trysomethingelse/blue_pill_battery_capacity_meter/kicad/batteryCapacityMeasure_STM32F103.kicad_pcb

## KiCad design kicad/batteryCapacityMeasure_STM32F103.kicad_pcb (2019-11-14)

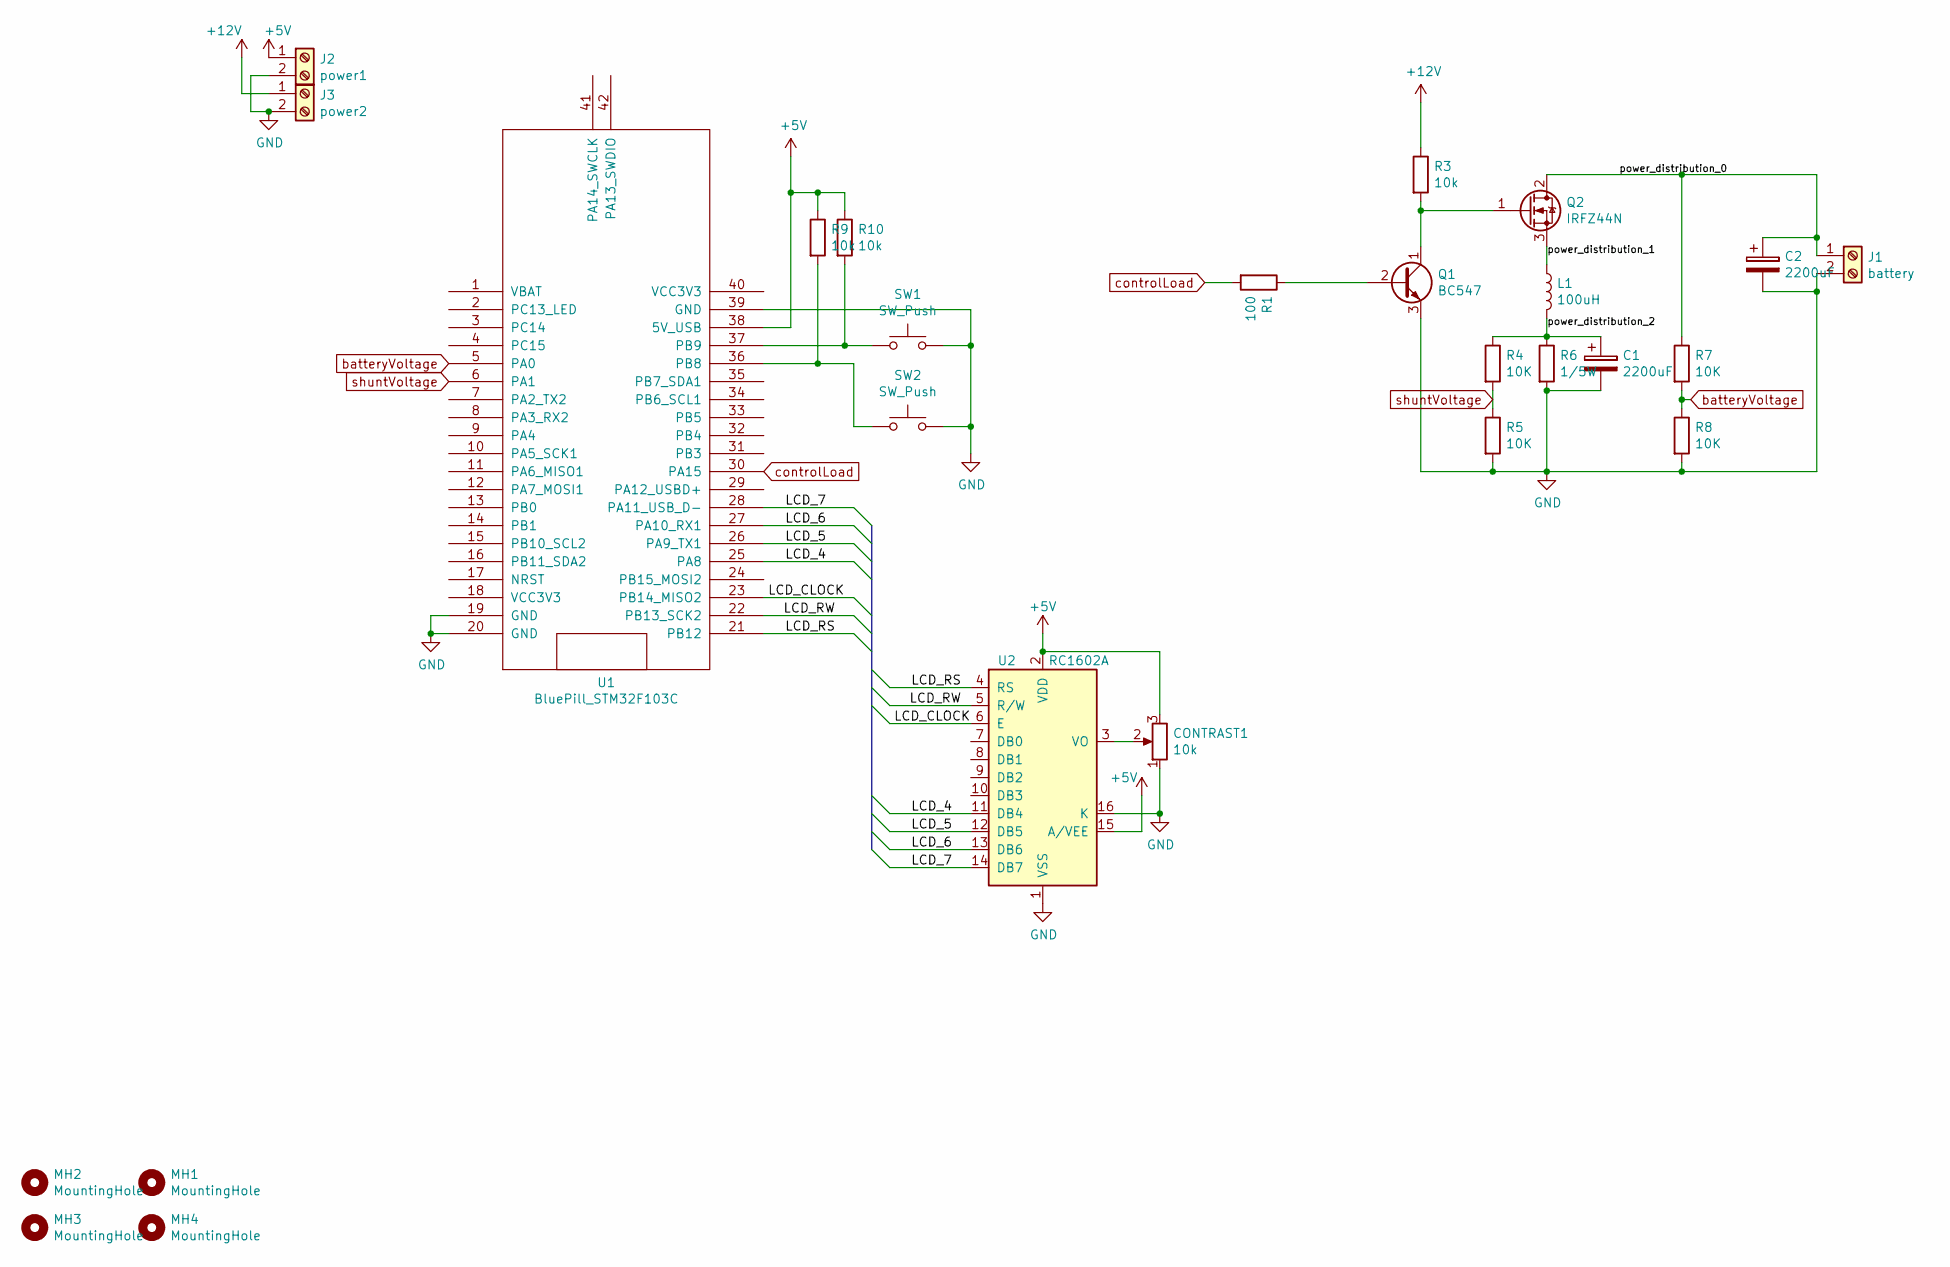
[picture p1: schematic batteryCapacityMeasure_STM32F103.sch]

Parts:
C1, C2: 2200uF; CP_Radial_D10.0mm_P7.50mm
CONTRAST1: 10k; Potentiometer_Trimmer_Piher_PT-10v10_Horizontal_Px10.0mm_Py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
J1: battery; TerminalBlock_bornier-2_P5.08mm
J2: power1; TerminalBlock_bornier-2_P5.08mm
J3: power2; TerminalBlock_bornier-2_P5.08mm
L1: 100uH; L_Radial_D7.5mm_P3.50mm_Fastron_07P
MH1, MH2, MH3, MH4: MountingHole; MountingHole_3.2mm_M3_Pad
Q1: BC547; TO-92_Inline_Wide
Q2: IRFZ44N; TO-220-3_Vertical
R1: 100; R_Axial_DIN0207_L6.3mm_D2.5mm_P7.62mm_Horizontal
R3, R9, R10: 10k; R_Axial_DIN0207_L6.3mm_D2.5mm_P7.62mm_Horizontal
R4, R5, R7, R8: 10K; R_Axial_DIN0207_L6.3mm_D2.5mm_P7.62mm_Horizontal
R6: 1/5W; power_resisor_7W
SW1, SW2: SW_Push; SW_PUSH_6mm_h7.3mm
U1: BluePill_STM32F103C; bluepill_dip40_stm32f103c8
U2: RC1602A; lcd_1602A

Connections:
+5V: CONTRAST1.3, J2.1, R9.1, R10.1, U1.38 (5V_USB), U2.2 (VDD), U2.15 (A/VEE)
+12V: J3.1, R3.1
/LCD_4: U1.25 (PA8), U2.11 (DB4)
/LCD_5: U1.26 (PA9_TX1), U2.12 (DB5)
/LCD_6: U1.27 (PA10_RX1), U2.13 (DB6)
/LCD_7: U1.28 (PA11_USB_D-), U2.14 (DB7)
/LCD_CLOCK: U1.23 (PB14_MISO2), U2.6 (E)
/LCD_RS: U1.21 (PB12), U2.4 (RS)
/LCD_RW: U1.22 (PB13_SCK2), U2.5 (R/W)
/power_distribution_0: C2.1, J1.1, Q2.2 (D), R7.1
/power_distribution_1: L1.1, Q2.3 (S)
/power_distribution_2: C1.1, L1.2, R4.1, R6.1
GND: C1.2, C2.2, CONTRAST1.1, J1.2, J2.2, J3.2, Q1.3 (E), R5.2, R6.2, R8.2, SW1.2, SW2.2, U1.19 (GND), U1.20 (GND), U1.39 (GND), U2.1 (VSS), U2.16 (K)
unnamed: CONTRAST1.2, U2.3 (VO)
unnamed: Q1.1 (C), Q2.1 (G), R3.2
unnamed: Q1.2 (B), R1.1
unnamed: R9.2, SW2.1, U1.36 (PB8)
unnamed: R10.2, SW1.1, U1.37 (PB9)
batteryVoltage: R7.2, R8.1, U1.5 (PA0)
controlLoad: R1.2, U1.30 (PA15)
shuntVoltage: R4.2, R5.1, U1.6 (PA1)

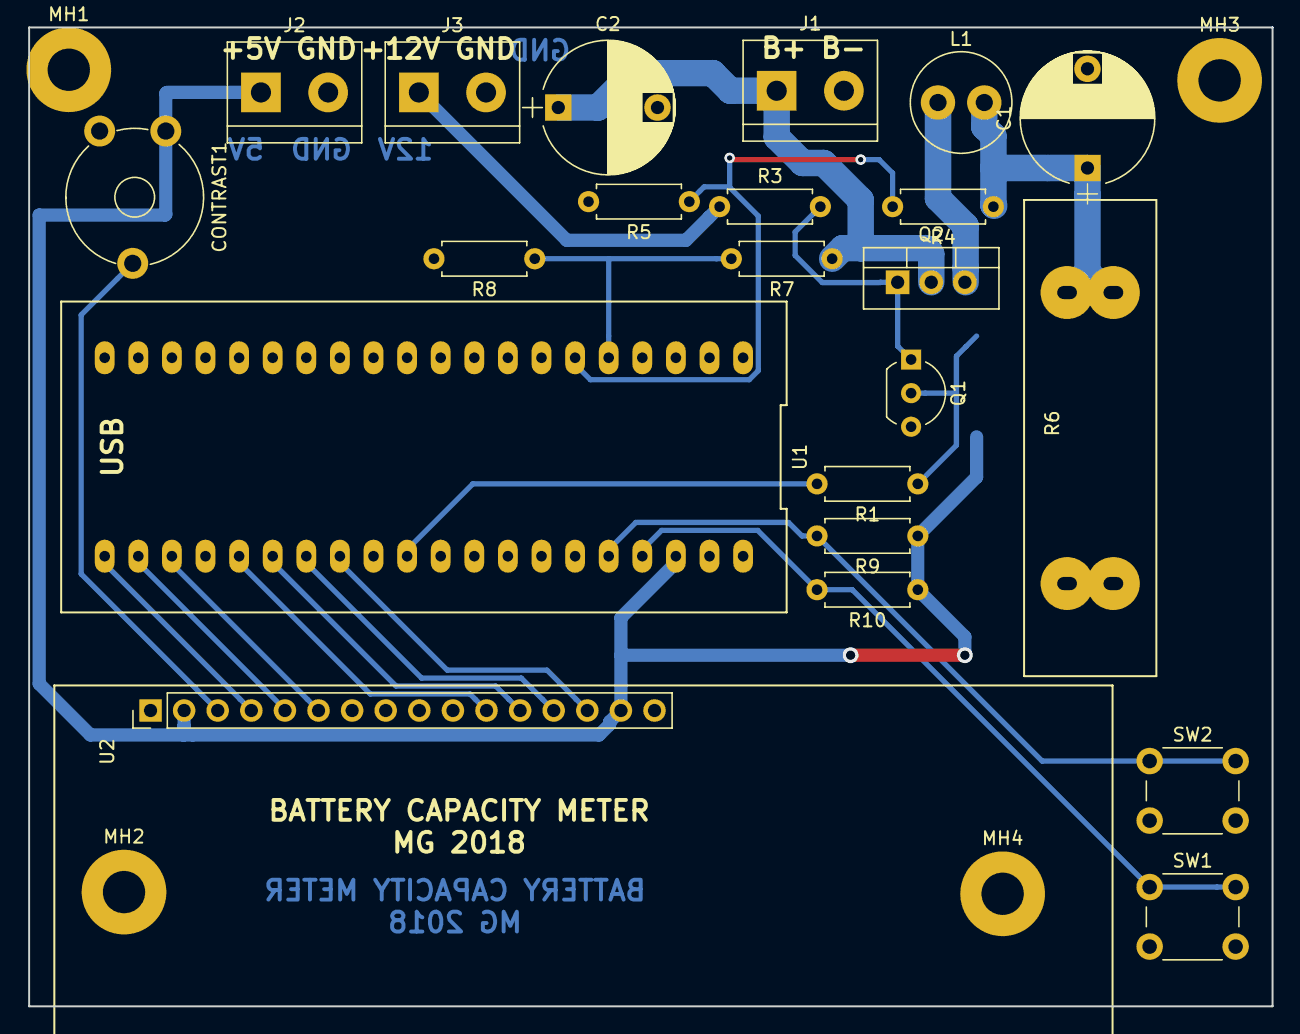
[picture p2: board batteryCapacityMeasure_STM32F103.kicad_pcb from above]

Board: 2 copper layers, 94.0 x 74.0 mm, 26 parts (0 on the bottom side), 21 nets.
