trysomethingelse/blue_pill_battery_capacity_meter/firmware/Src/main.c

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

/* Includes ------------------------------------------------------------------*/
#include "main.h"

/* USER CODE BEGIN PTD */
enum gpio_switch{SW1, SW2, NO_SW};
/* USER CODE END PTD */

ADC_HandleTypeDef hadc1;
ADC_HandleTypeDef hadc2;

RTC_HandleTypeDef hrtc;

TIM_HandleTypeDef htim2;
TIM_HandleTypeDef htim3;

/* USER CODE BEGIN PV */
enum gpio_switch SW_number = NO_SW;
volatile enum boolean should_actualize_lcd = FALSE;
volatile enum boolean should_actualize_adc =  FALSE;
volatile uint16_t battery_adc = 0;
volatile uint16_t shount_adc = 0;


uint16_t battery_voltage = 0;
uint16_t shount_current = 0;
uint16_t pwm_pulse = 0;
volatile double measured_energy = 0;
volatile int last_time = 0;

enum boolean measure_start = FALSE;
uint16_t discharging_current = 0;
uint16_t SW_counter[2] = {0,0};
uint16_t adjust_current_counter = 0;
/* USER CODE END PV */

void SystemClock_Config(void);
static void MX_GPIO_Init(void);
static void MX_TIM2_Init(void);
static void MX_TIM3_Init(void);
static void MX_ADC1_Init(void);
static void MX_ADC2_Init(void);
static void MX_RTC_Init(void);
/* USER CODE BEGIN PFP */
void switch_check(void);
void actualize_ADC(void);
void adjustShountCurrent(uint16_t current_to_set);
void cell_18650_measure(void);
void cell_18650_measure_const_current(void);
/* USER CODE END PFP */

/**
  * @brief  The application entry point.
  * @retval int
  */
int main(void)
{
  /* MCU Configuration--------------------------------------------------------*/

  /* Reset of all peripherals, Initializes the Flash interface and the Systick. */
  HAL_Init();

  /* Configure the system clock */
  SystemClock_Config();

  /* Initialize all configured peripherals */
  MX_GPIO_Init();
  MX_TIM2_Init();
  MX_TIM3_Init();
  MX_ADC1_Init();
  MX_ADC2_Init();
  MX_RTC_Init();
  /* USER CODE BEGIN 2 */
  HAL_TIM_Base_Start_IT(&htim3);
  HAL_ADCEx_Calibration_Start(&hadc1);
  HAL_ADCEx_Calibration_Start(&hadc2);
  HAL_TIM_PWM_Start(&htim2,TIM_CHANNEL_1);

  lcd_init();
  lcd_write(DISPLAY_HOME);
  /* USER CODE END 2 */

  /* Infinite loop */
  /* USER CODE BEGIN WHILE */
  HAL_RTC_Init(&hrtc);
  zeroTimer();

  while (1)
  {
	  if (should_actualize_lcd==TRUE)
	  {
		  should_actualize_lcd = FALSE;
		  actualize_LCD();

	  }
	  if (should_actualize_adc==TRUE)
	  {
		  should_actualize_adc= FALSE;
		  actualize_ADC();
		  adjustShountCurrent(discharging_current);
	  }
	  switch_check();
    /* USER CODE END WHILE */

    /* USER CODE BEGIN 3 */
  }
  /* USER CODE END 3 */
}

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
/* USER CODE BEGIN 4 */
void HAL_ADC_ConvCpltCallback(ADC_HandleTypeDef *hadc)
{
	//pass two values, because we don't know which one comes
	battery_adc = HAL_ADC_GetValue(&hadc1);
	shount_adc = HAL_ADC_GetValue(&hadc2);
	should_actualize_adc = TRUE;
}

void HAL_GPIO_EXTI_Callback(uint16_t GPIO_Pin)
{
 	if(GPIO_Pin == SW1_Pin)
 		SW_number = SW1;
 	if(GPIO_Pin == SW2_Pin)
 		SW_number = SW2;
}
void switch_check(void)
{
	 if (SW_number == SW1 && SW_counter[SW1] == 0 )//start - pause
	  {
		  SW_number = NO_SW;
		  SW_counter[SW1] = SWITCH_DEBOUNCE;
		  should_actualize_lcd = TRUE;
		  if (measure_start == TRUE)
		  {
			  measure_start = FALSE;
			  pauseTimer();
			  discharging_current = 0;
		  }
		  else
		  {
			  discharging_current = CELL_18650_TYPICAL_CURRENT;
			  measure_start = TRUE;
			  runTimer();
		  }
	  }
	  if (SW_number == SW2 && SW_counter[SW2] == 0 )//reset
	  {
		  SW_number = NO_SW;
		  SW_counter[SW2] = SWITCH_DEBOUNCE;
		  should_actualize_lcd = TRUE;
		  measure_start = FALSE;
		  zeroTimer();
		  pauseTimer();
		  discharging_current = 0;
		  measured_energy = 0;
	  }
}
void actualize_ADC(void)
{
	  battery_voltage = 2 *  battery_adc/4096.0 * 3300;
	  shount_current = 2 * shount_adc/4096.0 * 3300;
	  last_time += TIM3->CNT;
	  double delta_time = last_time/interrupt_time_counter_TIM3;

	  double measured_energy_delta = (battery_voltage/CELL_18650_VOLTAGE)*shount_current*(delta_time/1000.0);
	  measured_energy += measured_energy_delta/3600;

	  if (measure_start == TRUE)
	  {
		  //cell_18650_measure();
		  cell_18650_measure_const_current();
	  }
	  last_time = 0;
	  if(SW_counter[SW1] > 0) SW_counter[SW1]--;
	  if(SW_counter[SW2] > 0) SW_counter[SW2]--;
}
void adjustShountCurrent(uint16_t current_to_set)//current in mA
{
	if (adjust_current_counter == ADJUST_CURRENT_INTERVAL)
	{
		adjust_current_counter = 0;
		uint8_t shouldSetNew = TRUE;
		TIM_OC_InitTypeDef sConfigOC = {0};

		if (current_to_set == 0)
		{
			pwm_pulse = pwm_period;
		}
		else if (shount_current > current_to_set)//shount_current greater, so increase pwm because mosfet is N type
		{
			if (pwm_pulse != pwm_period)
				pwm_pulse++;
		}
		else if(shount_current < current_to_set)
		{
			if (pwm_pulse != 0)
				pwm_pulse--;
		}
		else
			shouldSetNew = FALSE;
		if (shouldSetNew == TRUE)
		{
			HAL_TIM_PWM_Stop(&htim2,TIM_CHANNEL_1);
			sConfigOC.OCMode = TIM_OCMODE_PWM1;
			sConfigOC.Pulse = pwm_pulse;
			sConfigOC.OCPolarity = TIM_OCPOLARITY_HIGH;
			sConfigOC.OCFastMode = TIM_OCFAST_DISABLE;
			if (HAL_TIM_PWM_ConfigChannel(&htim2, &sConfigOC, TIM_CHANNEL_1) != HAL_OK)
			{
				Error_Handler();
			}
			HAL_TIM_PWM_Start(&htim2,TIM_CHANNEL_1);
		}
	}
	else
	{
		adjust_current_counter++;
	}

}
void cell_18650_measure(void)
{
//	adjustShountCurrent(discharging_current);
	if(shount_current <= CELL_18650_MIN_CURRENT &&  battery_voltage <= CELL_18650_MIN_VOLTAGE) //measured - battery empty
	{
		measure_start = FALSE;
		discharging_current = 0;
		pauseTimer();
	}
	else if(battery_voltage <= CELL_18650_MIN_VOLTAGE)
	{
		discharging_current--;
	}
}
void cell_18650_measure_const_current(void)
{
	if(battery_voltage <= CELL_18650_MIN_VOLTAGE) //measured - battery empty
	{
		measure_start = FALSE;
		discharging_current = 0;
		pauseTimer();
	}
}
/* USER CODE END 4 */
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
