trysomethingelse/blue_pill_battery_capacity_meter/firmware/blue_pill_battery_capacity_meter.ioc

Mcu.UserName=STM32F103C8Tx
PA0-WKUP.Signal=ADCx_IN0
PA1.Signal=ADCx_IN1
PA10.Signal=GPIO_Output
PA11.Signal=GPIO_Output
PA15.Signal=S_TIM2_CH1_ETR
PA8.Signal=GPIO_Output
PA9.Signal=GPIO_Output
PB12.Signal=GPIO_Output
PB13.Signal=GPIO_Output
PB14.Signal=GPIO_Output
PB8.GPIO_Label=SW1
PB8.Signal=GPXTI8
PB9.GPIO_Label=SW2
PB9.Signal=GPXTI9
PC14-OSC32_IN.Signal=RCC_OSC32_IN
PC15-OSC32_OUT.Signal=RCC_OSC32_OUT
PD0-OSC_IN.Signal=RCC_OSC_IN
PD1-OSC_OUT.Signal=RCC_OSC_OUT
