trysomethingelse/blue_pill_battery_capacity_meter/(commit log)

2018-12-10 displaing time and interupts for switches
2018-12-12 timer3 works
2018-12-12 adc only for one channel
    working on injected mode
2018-12-14 integrating of energy
    result is quite good, but can be improved in numerical errors
    [blue_pill_battery_capacity_meter.ioc, main.c, main.h, menu.c, menu.h]
2018-12-15 timer 3 agrees with rtc
2018-12-15 integrating of energy is correct
    more tests required
    [main.c]
2018-12-15 pwm is running
    todo make variable pwm
2018-12-16 control of current works, measuring battery works
2019-02-11 improved measuring of 18650 cell, measuring in mAh for 18650, pause and reset works good
    [blue_pill_battery_capacity_meter.ioc, main.c, main.h, menu.c, menu.h]
2019-02-13 changed min battery voltage, improved lcd
2019-02-23 18650 added const current discharge
2019-02-23 fixed discharging current after end of measure
    [main.c]
2019-02-24 now current is adjusted in given interval, code gruped to more functions
2019-11-14 added pcb, tiding
    [batteryCapacityMeasure_STM32F103.kicad_pcb, batteryCapacityMeasure_STM32F103.sch]
