trysomethingelse/blue_pill_battery_capacity_meter/(notices)

Notices in the files:
firmware/Src/main.c:
COPYRIGHT(c) 2018 STMicroelectronics
(C) COPYRIGHT STMicroelectronics *****END OF FILE
